jerryxiee/TPMS-SP370-SP40-FXTH87-Programer-Development-Kit/SP370/SP37Program错误异常处理.pdf

www.xiaojijiji.com | 小鸡叽叽科技

# SP37Program 错误异常处理

版本号 | 文件创建日期 | 最后修改日期 | 作者 | 签核
V2.0 | 2016-03-22 | 2016-07-06 | Deathgod
V2.1 | - | 2016-09-02 | Deathgod
http://www.xiaojijiji.com/小鸡叽叽科技

感谢您支持小鸡叽叽科技，请保护作者的劳动成果，未经允许不得将资料、代码传送他人或者网络

## 1.SP37Program 打开异常

SP37Program 需要 Microsoft .NET Framework 运行环境。(本人使用的是 4.5 版本) 如果软件无法打开，或出现其他异常。请先下载安装 Microsoft .NET Framework 最低版本 4.0 (WIN XP 用户选择 4.0)

下载地址:
推荐百度自行搜索下载(4.5 版本，大小 66M 左右)

(以下为微软官网，在线安装，可能会耗费较长的时间)
https://www.microsoft.com/zh-cn/download/confirmation.aspx?id=30653

## 2.串口驱动安装(以 win7 系统为例子) CH340G 串口驱动

1. 插入烧录开发板(不带屏幕的板子)
2. 进入电脑“设备管理器”，查看串口驱动是否成功安装
3. 若出现右图所示，请先安装串口驱动“CH340G 串口驱动” windows 可能会自动安装，如果没有自动安装，请手动安装 文件位于” CH340G 串口驱动 WINXP WIN7 WIN10 共用”
4. 安装完成后重新拔插设备

## 3.手动安装 CH340G 串口驱动

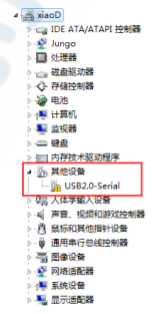
[picture p58: figure]

串口驱动未安装

STEP1

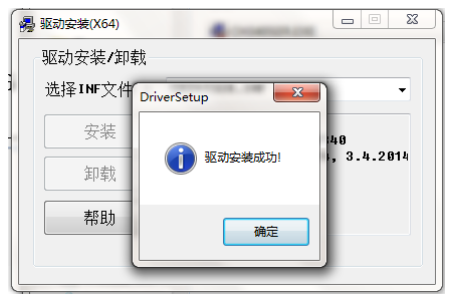
[picture p59: figure]
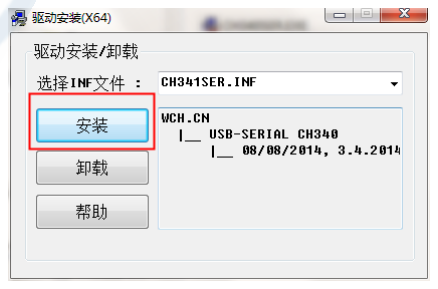
[picture p60: figure]

STEP2 | 成功安装

## 4.CH340G 驱动安装成功 “设备管理器可查看到 COM”

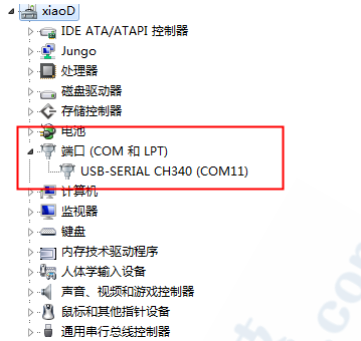
[picture p61: figure]

通过“设备管理器”也可以看到串口安装成功
这里串口号 COM11
