jerryxiee/TPMS-SP370-SP40-FXTH87-Programer-Development-Kit/SP400/Hardware/SP40 Module/bom.xlsx

Designator | LibRef | Footprint | Comment | Quantity
B1 | 纽扣电池 | CR1632 | 纽扣电池 | 1
C1, C2 | CAP | 0603_C | 8.2pF | 2
C3 | CAP | 0603_C | 68pF | 1
C4, C5 | CAP | 0603_C | 16pF | 2
C6 | CAP | 0603_C | 100nF | 1
C7 | CAP | 0603_C | 700nF | 1
C8 | CAP | 0603_C | 10nF | 1
C9 | CAP | 0603_C | 30pF | 1
C10 | CAP | 0603_C | 218pF | 1
L1 | Inductor | 0603_L | 56nH | 1
L2 | Inductor | 0603_L | 100nH | 1
L3 | Inductor | 0603_L | 15nH | 1
L4 | 低频电感 | EPCOS_7.2mH | 7.1mH | 1
P1 | Header 4 | HDR_2.0_4 | Header 4 | 1
P2 | Header 2 | HDR_2.0_2 | Header 2 | 1
Q1 | XTAL | XTAL_3225 | 26M | 1
R1 | RES | 0603_R | 41KOhm | 1
U1 | SP40 | SP40 | SP40 | 1
