jerryxiee/TPMS-SP370-SP40-FXTH87-Programer-Development-Kit/SP400/Hardware/SP40/SP40 Kit V2.0.pdf

# 螺丝孔

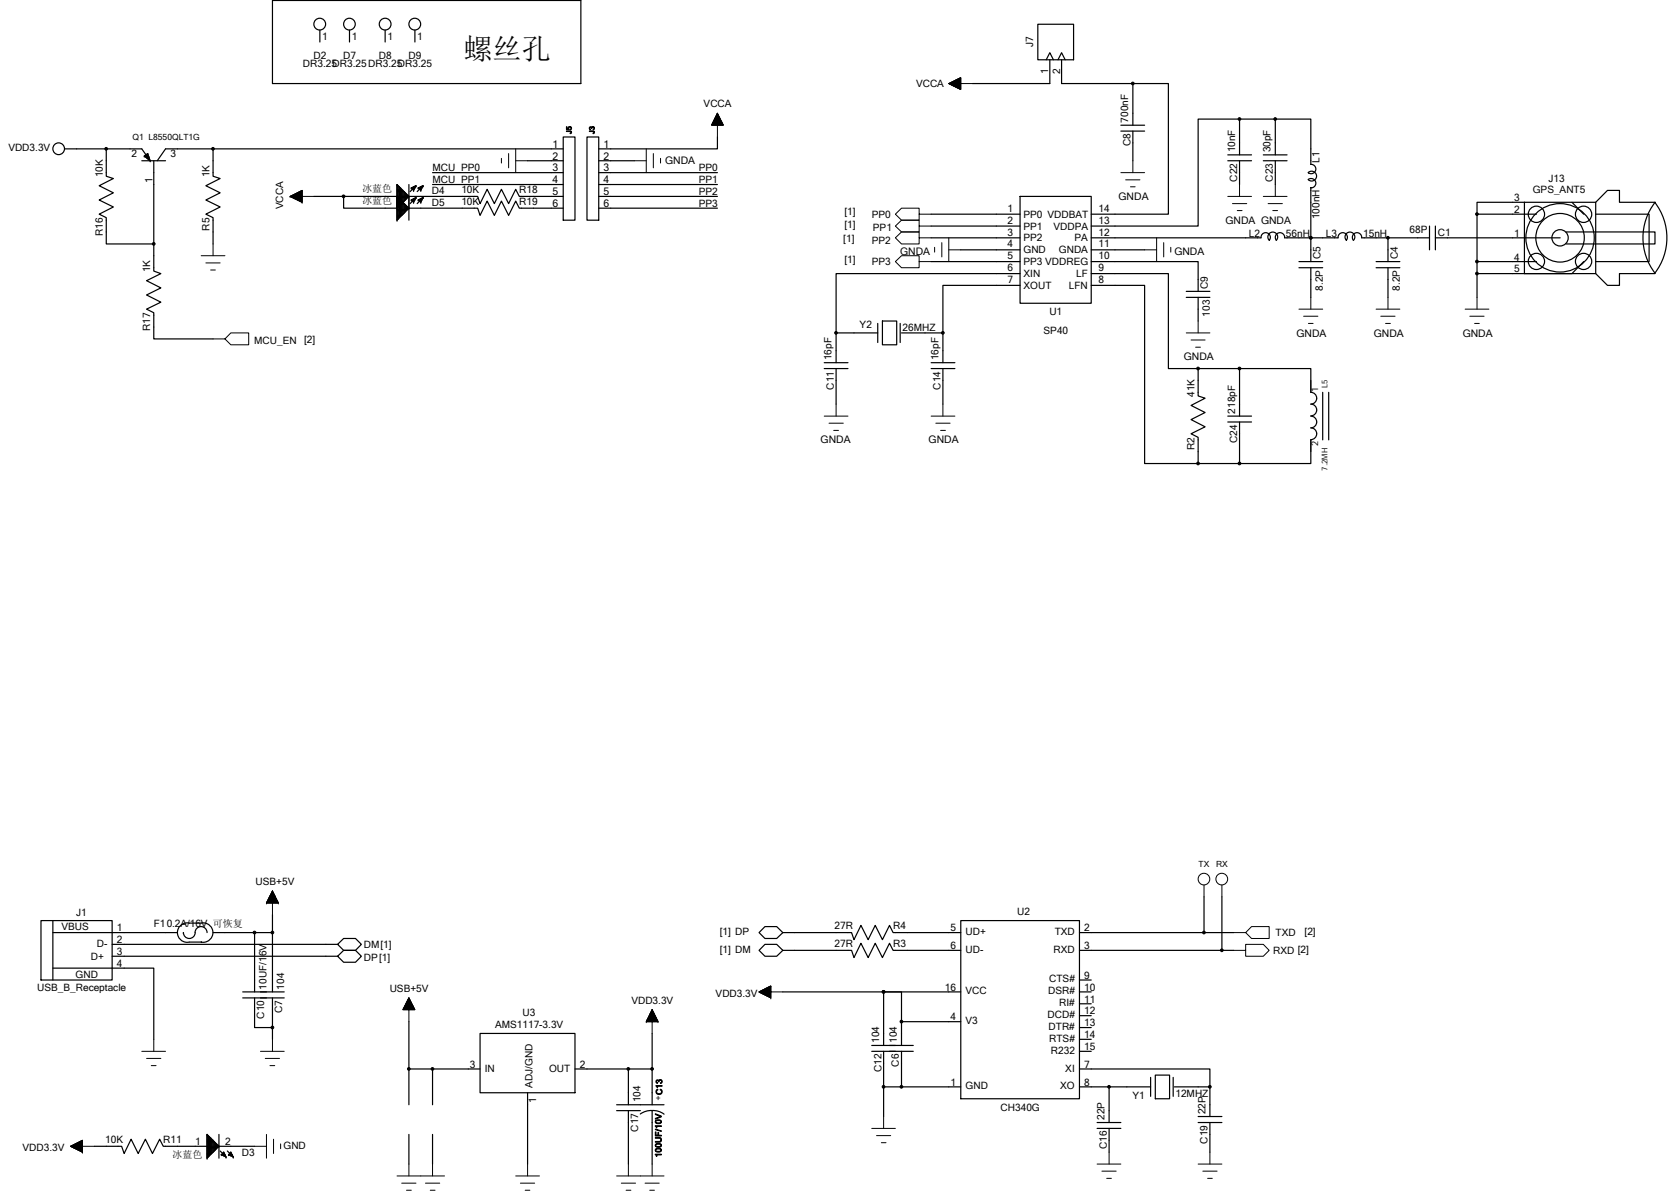
[picture p64: page 1]

1 ADJ/GND 3 OUT 2 IN

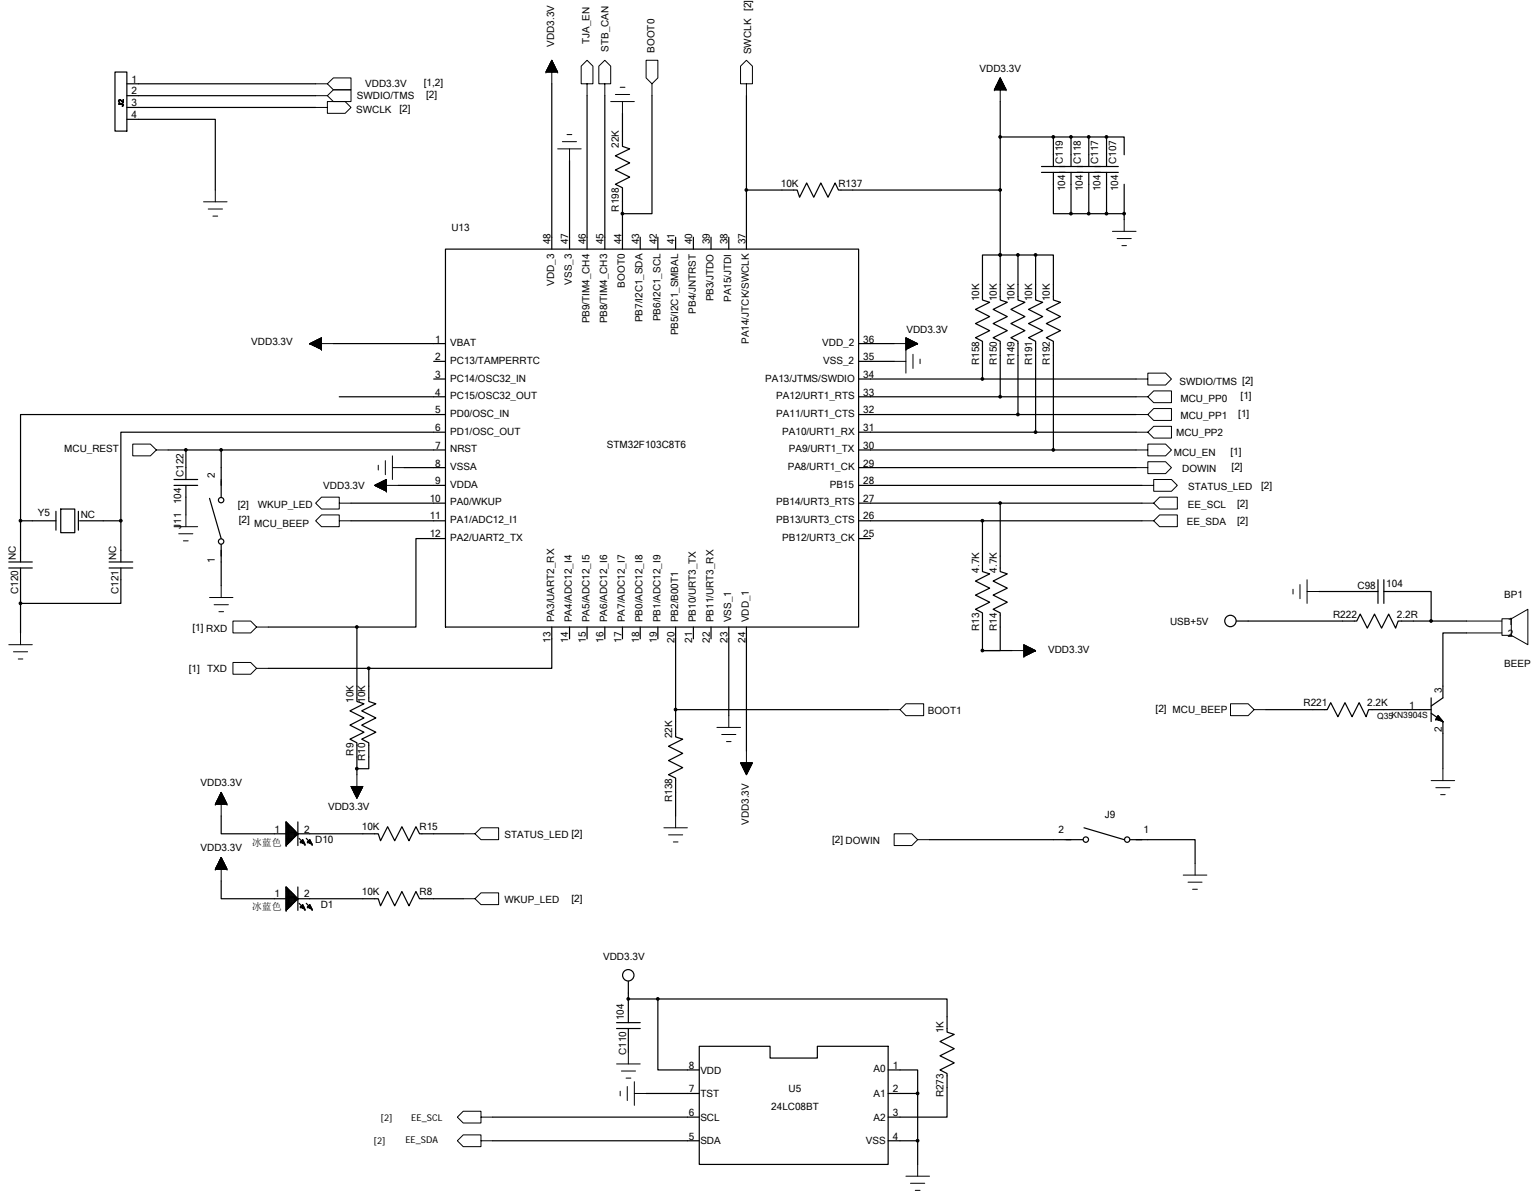
[picture p65: page 2]
