jerryxiee/TPMS-SP370-SP40-FXTH87-Programer-Development-Kit/SP370/Hardware/SP370 Kit E2.5.pdf

# 螺丝孔

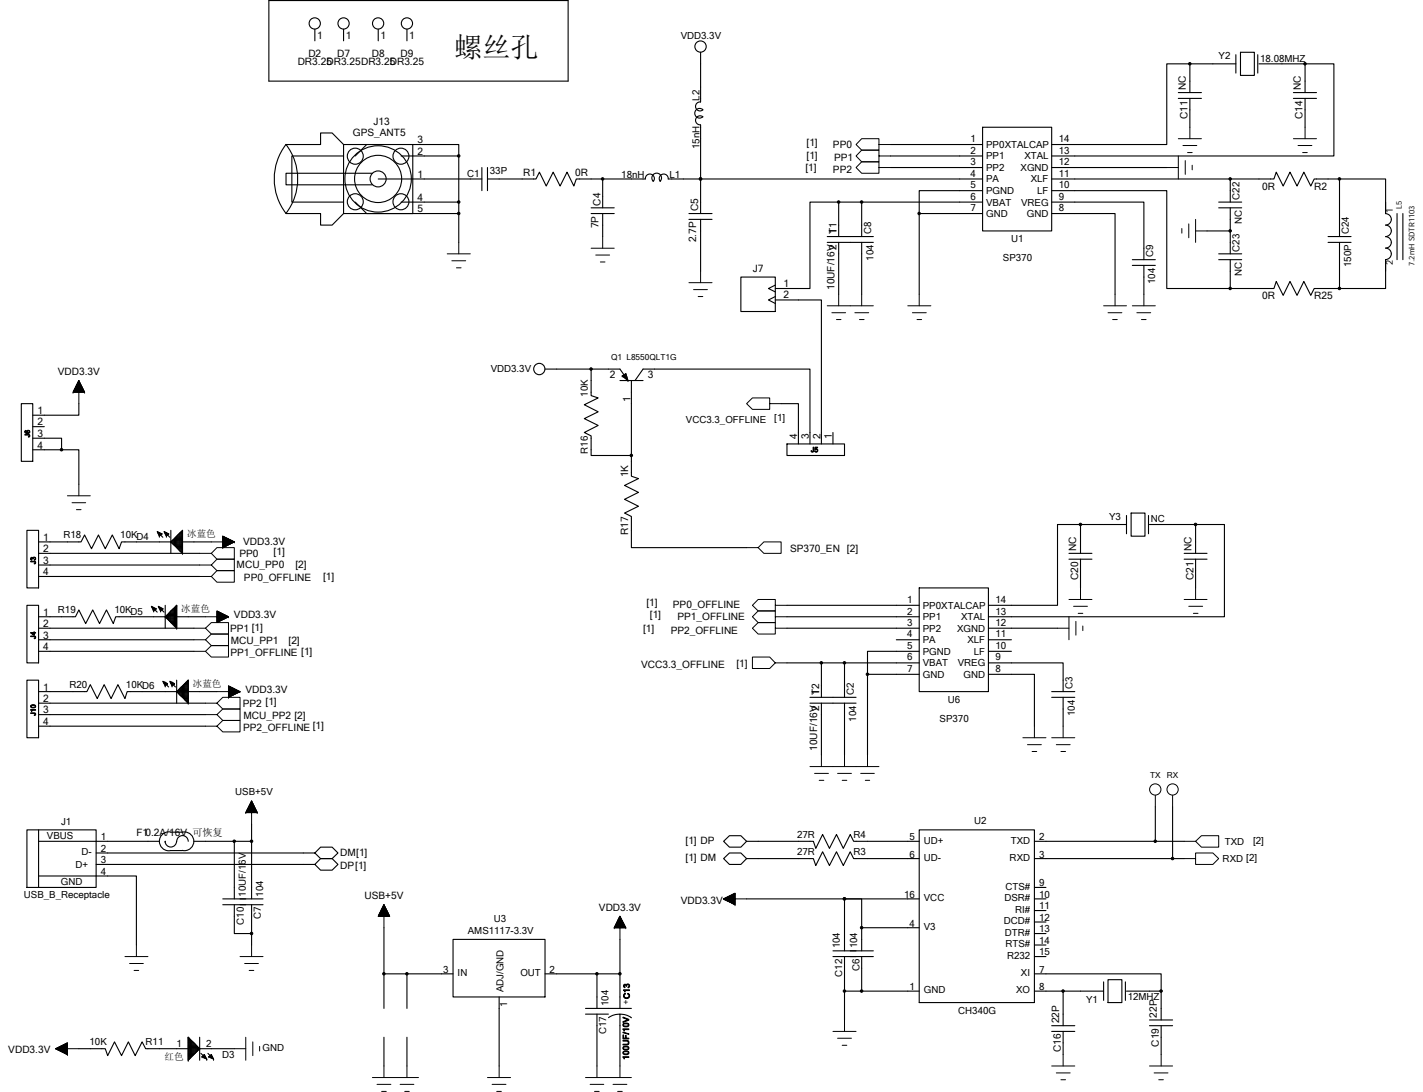
[picture p66: page 1]

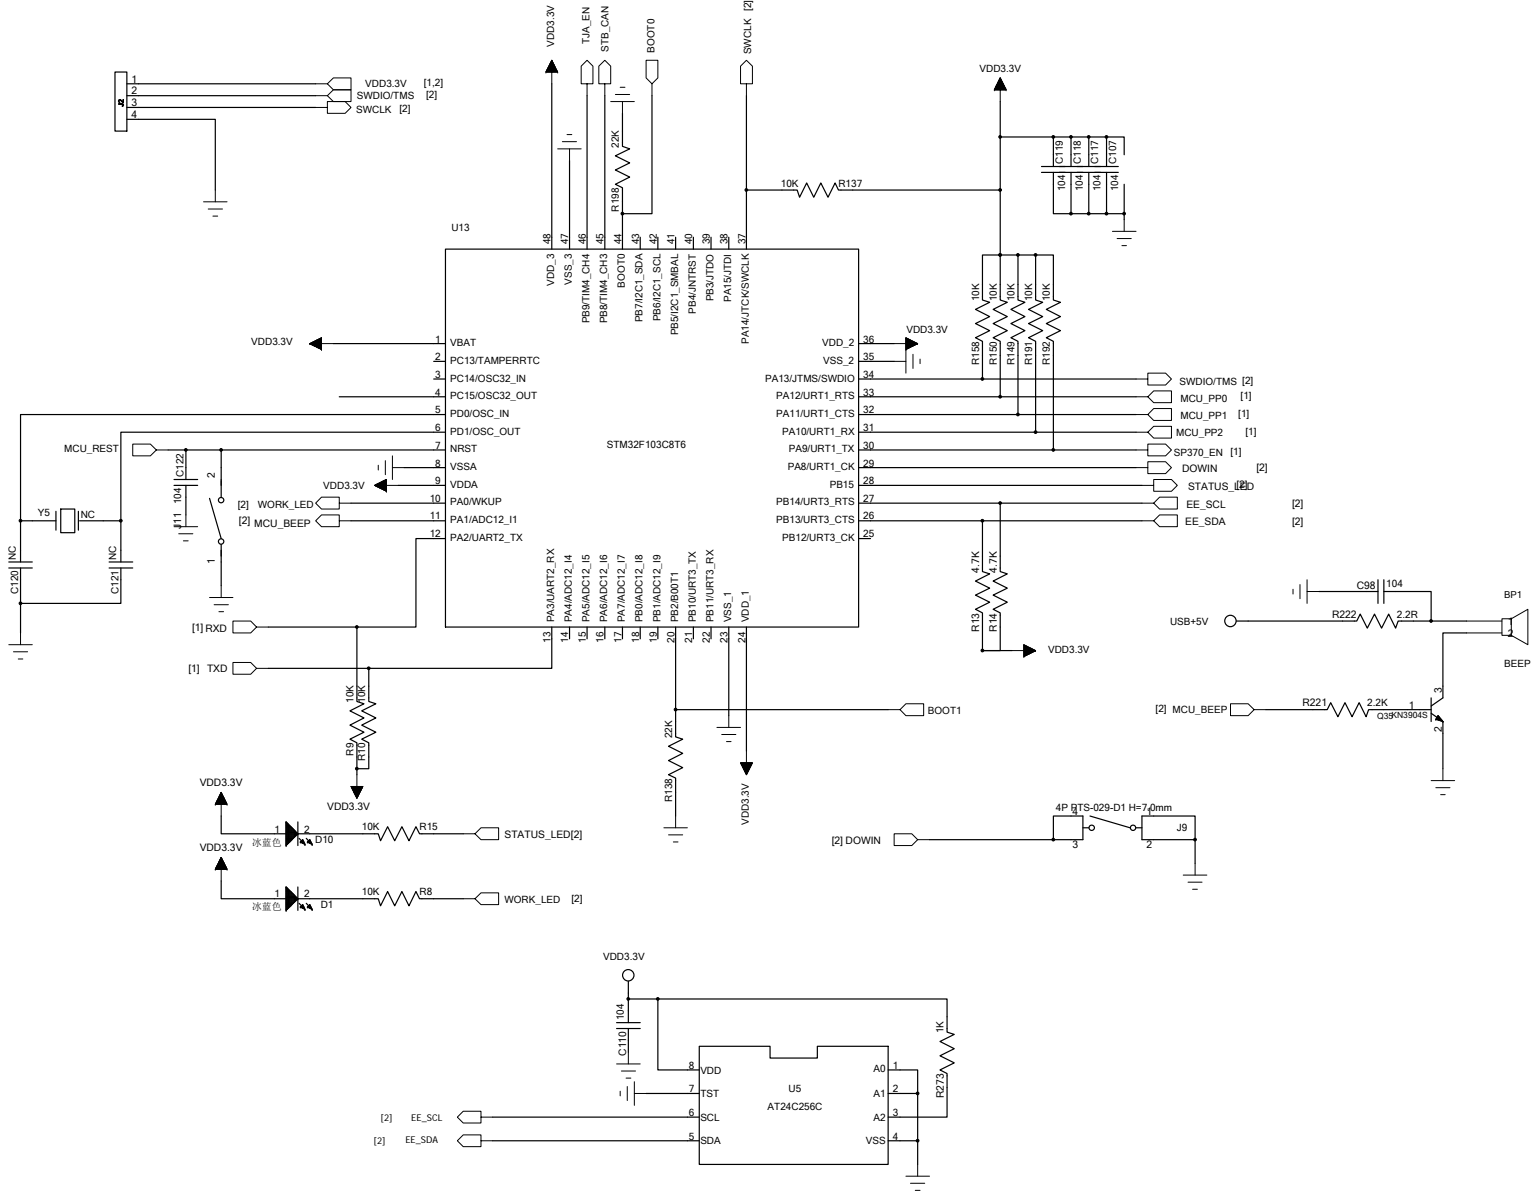
[picture p67: page 2]
