jerryxiee/TPMS-SP370-SP40-FXTH87-Programer-Development-Kit/SP370/Hardware/TDA5235 Kit V2.6.pdf

# 螺丝孔

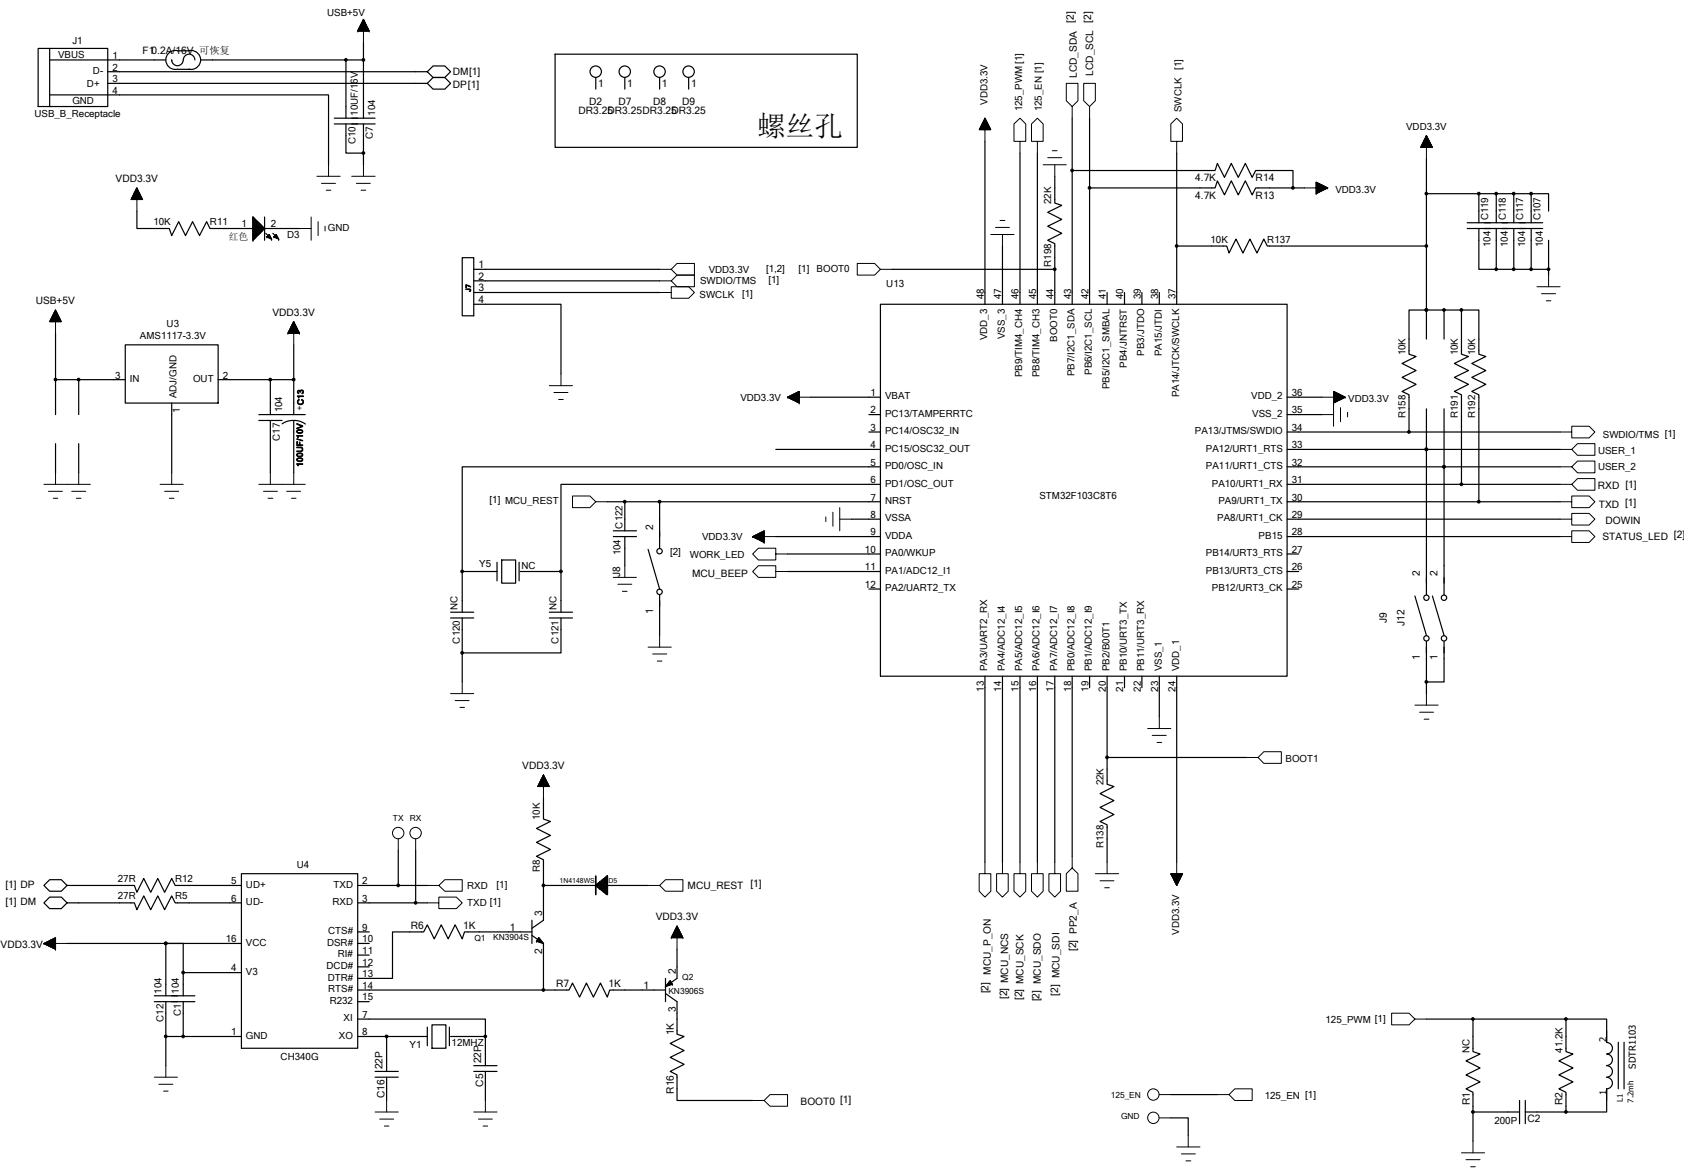
[picture p68: page 1]

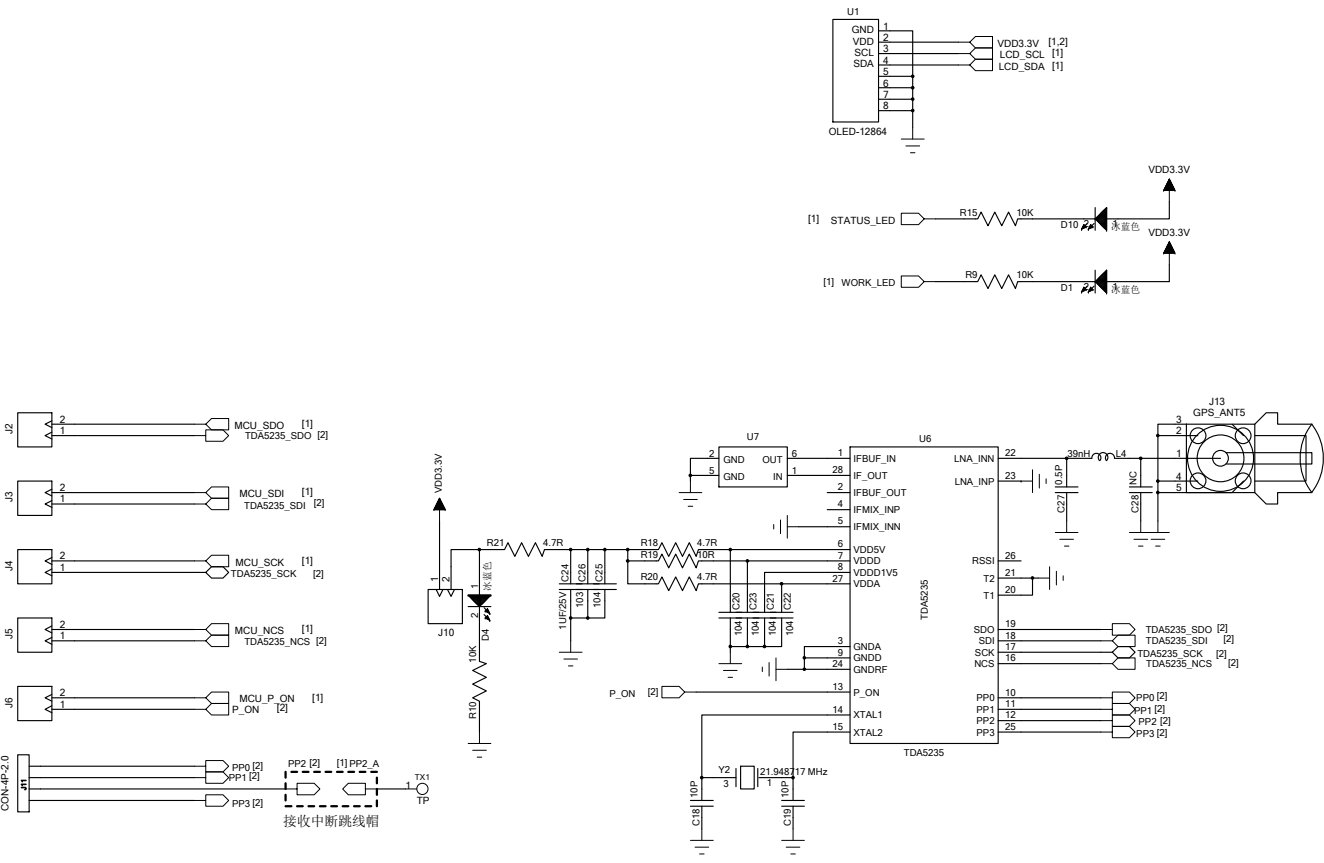
[picture p69: page 2]
