jerryxiee/TPMS-SP370-SP40-FXTH87-Programer-Development-Kit/FXTH87/Hardware/FXTH87 Kit/FXTH87 Kit V1.00.pdf

# ÂÝË¿¿×

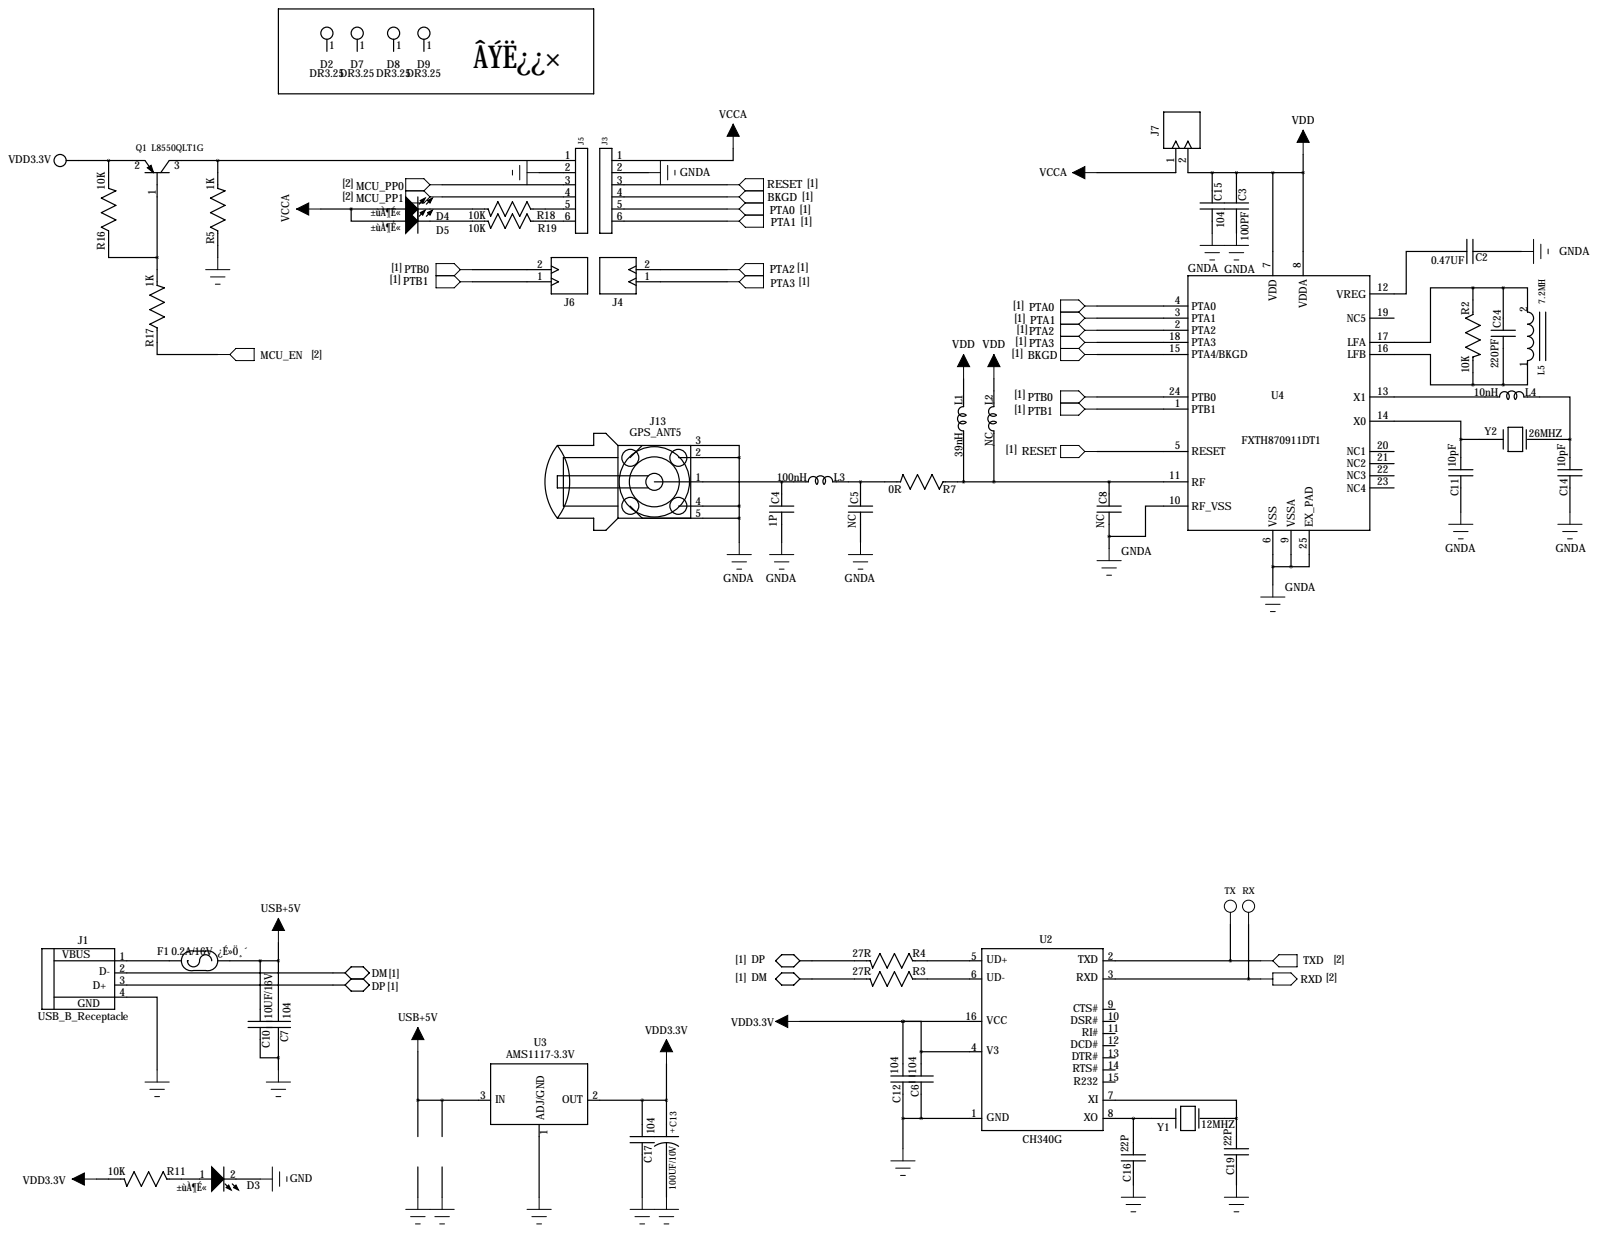
[picture p70: page 1]

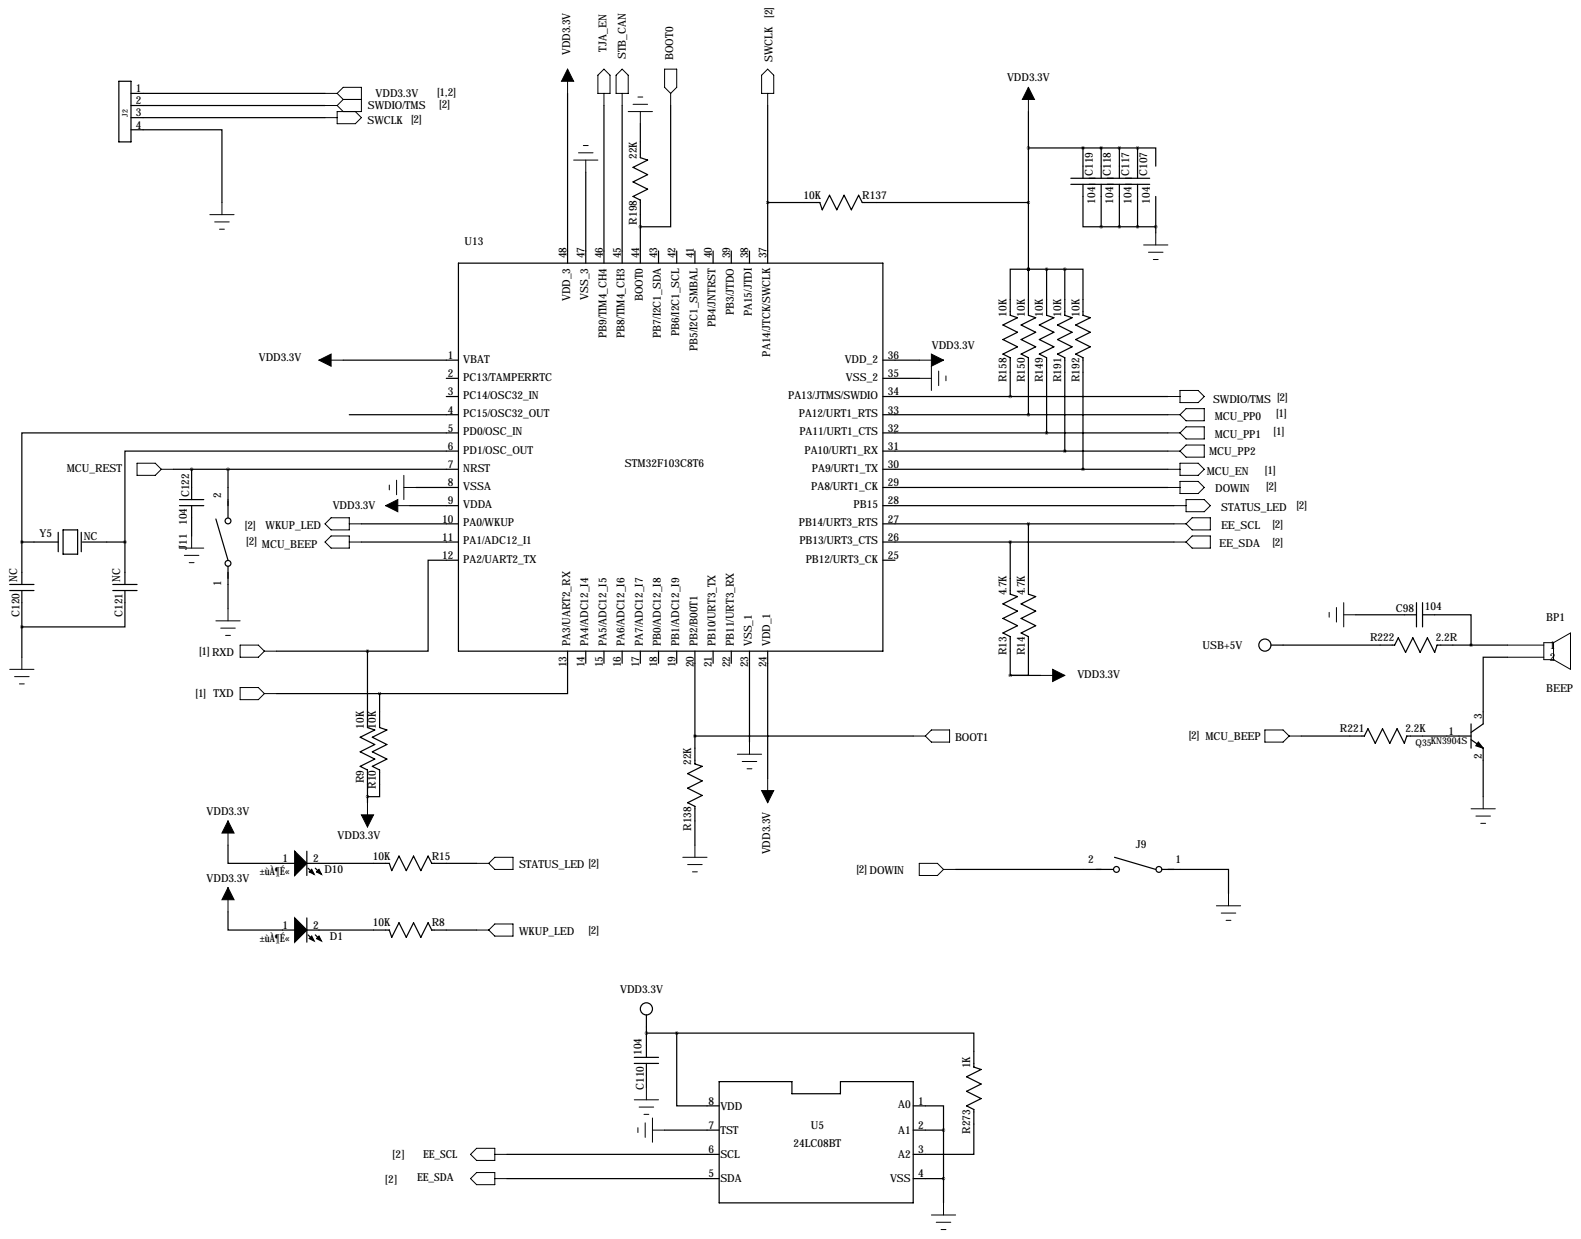
[picture p71: page 2]
