jerryxiee/TPMS-SP370-SP40-FXTH87-Programer-Development-Kit/SP400/Hardware/SP40 Module/V2.pdf

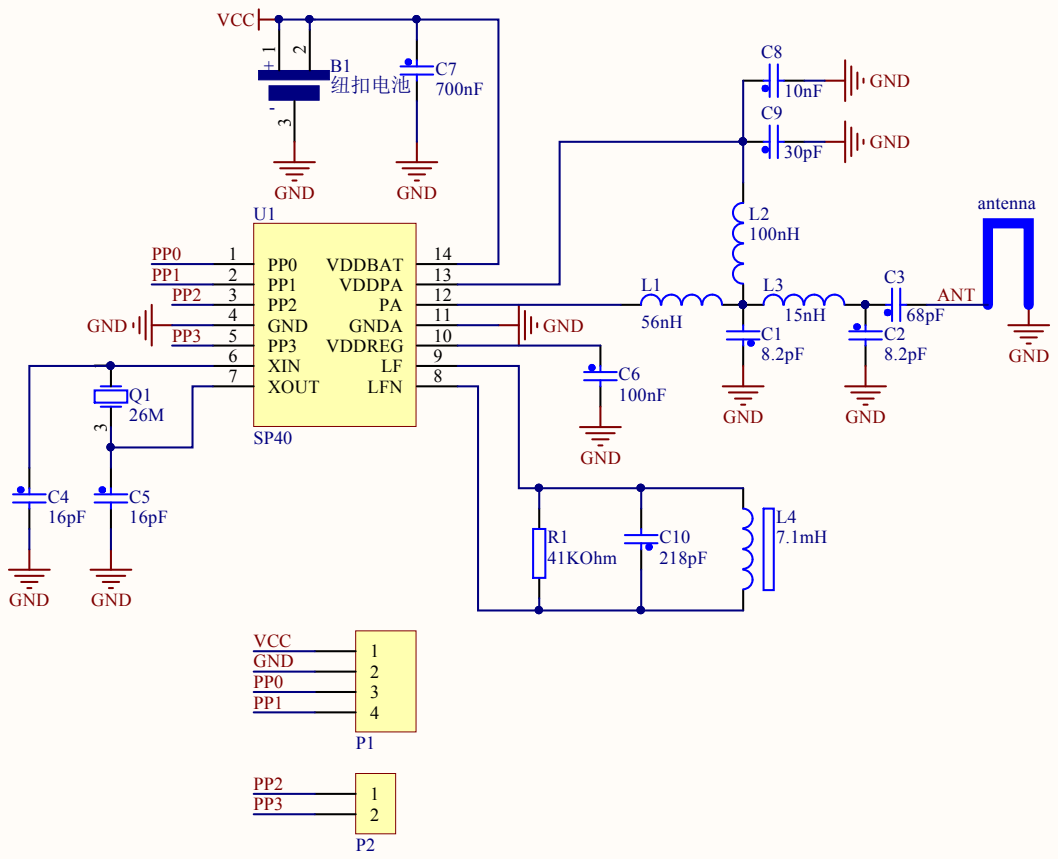
[picture p72: page 1]
