jerryxiee/TPMS-SP370-SP40-FXTH87-Programer-Development-Kit/SP370/TDA5235 Code/09.SP37_RFData_To_OLED_WithCRC/User/main.c

#include "sys.h"
#include "clock.h"
#include "delay.h"
#include "usart.h"
#include "led.h"
#include "tim.h"

#include "oled.h"
#include "display.h"

#include "TDA5235.h"
#include "TDA5235_SFR.h"

#include "SP37Data.h"


/* ************************************************************************************************** */
/* ************************************************************************************************** */
/* ************************************************************************************************** */
/* ************************************************************************************************** */
/*   ----------------------------------------------------------------------------------------------   */
/*                                          小鸡叽叽科技出品                                          */
/*                                         www.xiaojijiji.com                                         */
/*   ----------------------------------------------------------------------------------------------   */
/* ************************************************************************************************** */
/* ************************************************************************************************** */
/* ************************************************************************************************** */
/* ************************************************************************************************** */
/*   -----------------------------------------------------------------------------------------------  */
/*	                     感谢您支持小鸡叽叽科技，请遵守保密协议，保护作者的劳动成果，                 */
/*                                  未经允许请不要将资料、代码传送他人或者网络	                      */
/*                                             仅供内部使用                                           */
/* ************************************************************************************************** */


int main(void)
{

	Clock_Init();
	NVIC_Configuration();		//中断配置
	delay_init();
	LED_Init();
	USART1_Init(115200);		//USART1初始化,波特率115200	

	Tim3_Init(1000,64); 		//1ms的溢出中断 //系统灯闪烁
	TIM3_Cmd(ENABLE);


	OLED_Init(); 
 
	Display_Logo();  
	Display_Http();
	Display_Version();  

	Display_User_ID_NULL();
	Display_RF_Receive_Mark();

	Display_Pressure(0); 
	Display_Temperature(0);
	Display_Acceleration(0);
	Display_Voltage(0);

	TDA5235_Init();
	TDA5235_SFR_Init();
	
	while(1)
	{
		if(TDA5235_FIFO_NUM){
			PT_SP37_RF_DATA pt_SP37Data = (PT_SP37_RF_DATA)TDA5235_FIFO;

			LED_ReceiveReverse();		//STATUS灯闪烁
			Display_RF_Receive_Count_Plus();
			Display_Logo_Move();

			Display_User_ID(pt_SP37Data->IDH,pt_SP37Data->IDL);
			Display_Pressure(SP37_Cal_Pressure(pt_SP37Data->Pressure));
			Display_Temperature(SP37_Cal_Temperature(pt_SP37Data->Temperature));
			Display_Acceleration(SP37_Cal_Acceleration(pt_SP37Data->Acceleration));
			Display_Voltage(SP37_Cal_Voltage(pt_SP37Data->Voltage));

			TDA5235_FIFO_NUM = 0;	//清零

			printf("*****************************\r\n");
			printf("Get a message from SP370:\r\n");
			printf("Pressure:    %f\r\n",SP37_Cal_Pressure(pt_SP37Data->Pressure));
			printf("Temperature: %f\r\n",SP37_Cal_Temperature(pt_SP37Data->Temperature));
			printf("Acceleration:%f\r\n",SP37_Cal_Acceleration(pt_SP37Data->Acceleration));
			printf("Voltage:     %f\r\n",SP37_Cal_Voltage(pt_SP37Data->Voltage));
			printf("*****************************\r\n");
		}
	}


}


/*	头文件路径
.\CORE;..\FWLib\inc;.\INCLUDE
*/
