jerryxiee/TPMS-SP370-SP40-FXTH87-Programer-Development-Kit/SP370/SP370 Code/03.UART/user/main.c

/* ************************************************************************************************** */
/* ************************************************************************************************** */
/* ************************************************************************************************** */
/* ************************************************************************************************** */
/*   ----------------------------------------------------------------------------------------------   */
/*                                          小鸡叽叽科技出品		                                  		*/
/*                                         www.xiaojijiji.com		                                  		*/
/*   ----------------------------------------------------------------------------------------------   */
/* ************************************************************************************************** */
/* ************************************************************************************************** */
/* ************************************************************************************************** */
/* ************************************************************************************************** */
/*   -----------------------------------------------------------------------------------------------  */
/*	                     感谢您支持小鸡叽叽科技，请遵守保密协议，保护作者的劳动成果，                 */
/*                                  未经允许请不要将资料、代码传送他人或者网络	                      */
/*																		         仅供内部使用                                           */
/* ************************************************************************************************** */



#include "Reg_SP37.h"
#include "SP37_ROMLibrary.h"
#include <uart.h>
#include <stdio.h>
#include <ctype.h>

void MAIN(void)
{
	Uart_Init();
	
	while(1){

		WDRES = 1;		//喂看门狗
		printf("%s\r\n","SP370 Printf Test...");
		printf("十进制:%d\r\n",10000);
		printf("字符:%c\r\n",'A');
		//打印16进制需要将数据强制为int
		printf("十六进制:0x%X\r\n",(int)0xAA);

		//延时1S
		Wait100usMultiples(10000);
	}
}
