jerryxiee/TPMS-SP370-SP40-FXTH87-Programer-Development-Kit/SP370/SP370 Code/04.Temperature/user/main.c

/* ************************************************************************************************** */
/* ************************************************************************************************** */
/* ************************************************************************************************** */
/* ************************************************************************************************** */
/*   ----------------------------------------------------------------------------------------------   */
/*                                          小鸡叽叽科技出品		                                  		*/
/*                                         www.xiaojijiji.com		                                  		*/
/*   ----------------------------------------------------------------------------------------------   */
/* ************************************************************************************************** */
/* ************************************************************************************************** */
/* ************************************************************************************************** */
/* ************************************************************************************************** */
/*   -----------------------------------------------------------------------------------------------  */
/*	                     感谢您支持小鸡叽叽科技，请遵守保密协议，保护作者的劳动成果，                 */
/*                                  未经允许请不要将资料、代码传送他人或者网络	                      */
/*																		         仅供内部使用                                           */
/* ************************************************************************************************** */


#include "Reg_SP37.h"
#include "SP37_ROMLibrary.h"
#include <uart.h>
#include <stdio.h>
#include <ctype.h>


void MAIN(void)
{
	unsigned char StatusByte;
	struct{
		signed int Compensated_Temperature;
		signed int Raw_Temperature;
	}idata Temp_Result;

	//串口初始化
	Uart_Init();

	while(1)
	{
		WDRES = 1;
		StatusByte = Meas_Temperature(&Temp_Result.Compensated_Temperature);
		if(!StatusByte)
		{
			printf("The Temperature is %f\r\n",(double)Temp_Result.Compensated_Temperature/128);
		}
		else
		{
			printf("The Temperature Measure Error\r\n");
		}
		Wait100usMultiples(1000);
	}

}
