jerryxiee/TPMS-SP370-SP40-FXTH87-Programer-Development-Kit/SP370/TDA5235 Code/03.USART/User/main.c

#include "sys.h"
#include "clock.h"
#include "delay.h"
#include "usart.h"

#include "led.h"


/* ************************************************************************************************** */
/* ************************************************************************************************** */
/* ************************************************************************************************** */
/* ************************************************************************************************** */
/*   ----------------------------------------------------------------------------------------------   */
/*                                          小鸡叽叽科技出品                                          */
/*                                         www.xiaojijiji.com                                         */
/*   ----------------------------------------------------------------------------------------------   */
/* ************************************************************************************************** */
/* ************************************************************************************************** */
/* ************************************************************************************************** */
/* ************************************************************************************************** */
/*   -----------------------------------------------------------------------------------------------  */
/*	                     感谢您支持小鸡叽叽科技，请遵守保密协议，保护作者的劳动成果，                 */
/*                                  未经允许请不要将资料、代码传送他人或者网络	                      */
/*                                             仅供内部使用                                           */
/* ************************************************************************************************** */


int main(void)
{

	Clock_Init();
	NVIC_Configuration();		//中断配置
	delay_init();
	USART1_Init(115200);		//USART1初始化,波特率115200

	LED_Init();

	while(1)
	{
		printf("-------------------------------\r\n");
		printf("%s\r\n","STM32 Printf Test...");
		printf("十进制:%d\r\n",10000);
		printf("字符型:%c\r\n",'A');
		printf("十六进制:0x%02X\r\n",0xAA);
		printf("浮点数:%f\r\n",1.2345678);
		printf("www.xiaojijiji.com\r\n");
		printf("Designed By Deathgod\r\n");
		printf("-------------------------------\r\n");
		delay_ms(500);

	}

}


/*	头文件路径
.\CORE;..\FWLib\inc;.\INCLUDE
*/
