jerryxiee/TPMS-SP370-SP40-FXTH87-Programer-Development-Kit/SP370/TDA5235 Code/04.GET_TDA5235_ID/User/main.c

#include "sys.h"
#include "clock.h"
#include "delay.h"
#include "usart.h"

#include "led.h"

#include "TDA5235.h"
#include "TDA5235_SFR.h"

/* ************************************************************************************************** */
/* ************************************************************************************************** */
/* ************************************************************************************************** */
/* ************************************************************************************************** */
/*   ----------------------------------------------------------------------------------------------   */
/*                                          小鸡叽叽科技出品                                          */
/*                                         www.xiaojijiji.com                                         */
/*   ----------------------------------------------------------------------------------------------   */
/* ************************************************************************************************** */
/* ************************************************************************************************** */
/* ************************************************************************************************** */
/* ************************************************************************************************** */
/*   -----------------------------------------------------------------------------------------------  */
/*	                     感谢您支持小鸡叽叽科技，请遵守保密协议，保护作者的劳动成果，                 */
/*                                  未经允许请不要将资料、代码传送他人或者网络	                      */
/*                                             仅供内部使用                                           */
/* ************************************************************************************************** */


int main(void)
{

	Clock_Init();
	NVIC_Configuration();		//中断配置
	delay_init();
	USART1_Init(115200);		//USART1初始化,波特率115200

	LED_Init();

	TDA5235_Init();
	
	while(1)
	{
		u8 i;
		u8 ID[4] = {0};

		for(i=0;i<4;i++){
			ID[i] = TDA5235_Read_Register(SFR_SN0 + i);
		}

		printf("TDA5235 ID: ");
		for(i=0;i<4;i++){
			printf("%02X,",ID[i]);
		}
		printf("\r\n");
		
		delay_ms(500);		
	}


}


/*	头文件路径
.\CORE;..\FWLib\inc;.\INCLUDE
*/
