jerryxiee/TPMS-SP370-SP40-FXTH87-Programer-Development-Kit/SP370/TDA5235 Code/11.Send_125Khz_LF_Telegram/User/display.c

#include "sys.h"
#include "oled.h"
#include "display.h"

#include "mysprintf.h"

#include <math.h>

#include "sp37data.h"

//默认显示在第一行,与第二行的第一个像素点
void Display_Logo(void)
{
	OLED_ShowBMP(LOGO_START_X,LOGO_START_PAGE,0);
	//OLED_ShowBMP(LOGO_MOVE_X_MIN,LOGO_MOVE_PAGE,1);
}

void Display_Http(void)
{
	OLED_ShowStr(HTTP_START_X,HTTP_START_PAGE,"www.xiaojijiji.com");
}

void Display_Version(void)
{
	//OLED_ShowStr(VERSION_START_X,VERSION_START_PAGE,"SP37 Receiver V2.5");
	OLED_ShowStr(VERSION_START_X,VERSION_START_PAGE," .Send 125Khz LF. ");
}


#define LOGO_MOVE_TO_RIGHT	0
#define LOGO_MOVE_TO_LEFT	1	

void Display_Logo_Move(void)
{
	static u8 pos = 0;
	static u8 dir = LOGO_MOVE_TO_RIGHT;

	OLED_CleanBMP(pos,LOGO_MOVE_PAGE);

	if(dir==LOGO_MOVE_TO_RIGHT){		//向右移动
		pos ++;
		if(pos >= LOGO_MOVE_X_MAX){
			dir = LOGO_MOVE_TO_LEFT;
		}
		OLED_ShowBMP(pos,LOGO_MOVE_PAGE,1);
	}else{								//向左移动
		pos --;
		if(pos <= LOGO_MOVE_X_MIN){
			dir = LOGO_MOVE_TO_RIGHT;
		}
		OLED_ShowBMP(pos,LOGO_MOVE_PAGE,0);
	}
	
	

}

//默认16个数据
//没有更新的地方为0
void Display_Data(u8 *data)
{
	u8 i;

	char strArr[32]={0};
	char *str = strArr;

	//第一行数据	
	*str = 'D';	str++;
	*str = '0';	str++;
	*str = ':';	str++;

	for(i=0;i<8;i++){
		str += MySprintf_x(str,data[i]);
	}

	OLED_ShowStr(DATA_START_X,DATA_START_PAGE1,strArr);

	//第二行数据
	str = strArr;
	*str = 'D';	str++;
	*str = '1';	str++;
	*str = ':';	str++;

	for(i=8;i<16;i++){
		str += MySprintf_x(str,data[i]);
	}

	OLED_ShowStr(DATA_START_X,DATA_START_PAGE2,strArr);	
	
}

//显示" Re: "  这个三个字符串
void Display_RF_Receive_Mark(void)
{
	char strArr[32]={0};
	char *str = strArr;

	*str = 'R';	str++;
	*str = 'e';	str++;
	*str = ':';	str++;

	MySprintf_ud(str,0,4);
	OLED_ShowStr(RF_RECEIVE_MARK_START_X,RF_RECEIVE_MARK_PAGE,strArr);	
}


void Display_RF_Receive_Count_Plus(void)
{
	char strArr[32]={0};
	char *str = strArr;

	static u16 Count = 0;

	Count ++;
	if(Count > 9999){
		Count = 0;
	}
	
	MySprintf_ud(str,Count,4);
	OLED_ShowStr(RF_RECEIVE_COUNT_START_X,RF_RECEIVE_COUNT_PAGE,strArr);
}

//在没有收到ID之前，显示XXXX
void Display_User_ID_NULL(void)
{
	char strArr[32]={0};
	char *str = strArr;

	*str = 'I';	str++;
	*str = 'D';	str++;
	*str = ':';	str++;
	
	*str = 'X';	str++;
	*str = 'X';	str++;
	*str = 'X';	str++;
	*str = 'X';	str++;

	OLED_ShowStr(USER_ID_START_X,USER_ID_START_PAGE,strArr);

}

void Display_User_ID(u8 IDH,u8 IDL)
{
	char strArr[32]={0};
	char *str = strArr;

	static u8 lastIDH = 0xFF;
	static u8 lastIDL = 0xFF;

	if(lastIDH==IDH && lastIDL==IDL){
		return;
	}else{
		lastIDH = IDH;
		lastIDL = IDL;
	}

	*str = 'I';	str++;
	*str = 'D';	str++;
	*str = ':';	str++;
	
	str += MySprintf_x(str,IDH);
	str += MySprintf_x(str,IDL);

	OLED_ShowStr(USER_ID_START_X,USER_ID_START_PAGE,strArr);
}



//在没有收到ID之前，显示XXXXXXXX
void Display_Unique_ID_NULL(void)
{
	char strArr[32]={0};
	char *str = strArr;

	*str = 'I';	str++;
	*str = 'D';	str++;
	*str = ':';	str++;
	
	*str = 'X';	str++;
	*str = 'X';	str++;
	*str = 'X';	str++;
	*str = 'X';	str++;
	*str = 'X';	str++;
	*str = 'X';	str++;
	*str = 'X';	str++;
	*str = 'X';	str++;

	OLED_ShowStr(UNIQUE_ID_START_X,UNIQUE_ID_START_PAGE,strArr);

}

void Display_Unique_ID(u8 *UniqueID)
{
	char strArr[32]={0};
	char *str = strArr;

	static u8 lastUniqueID[4] = {0xFF,0XFF,0xFF,0xFF};

	if(	lastUniqueID[0]==UniqueID[0] && 
		lastUniqueID[1]==UniqueID[1] &&
		lastUniqueID[2]==UniqueID[2] && 
		lastUniqueID[3]==UniqueID[3]){
		return;
	}else{
		lastUniqueID[0]=UniqueID[0];
		lastUniqueID[1]=UniqueID[1];
		lastUniqueID[2]=UniqueID[2];
		lastUniqueID[3]=UniqueID[3];
	}

	*str = 'I';	str++;
	*str = 'D';	str++;
	*str = ':';	str++;
	
	str += MySprintf_x(str,UniqueID[0]);
	str += MySprintf_x(str,UniqueID[1]);
	str += MySprintf_x(str,UniqueID[2]);
	str += MySprintf_x(str,UniqueID[3]);

	OLED_ShowStr(UNIQUE_ID_START_X,UNIQUE_ID_START_PAGE,strArr);
}


void Display_Tyre_Position(u8 tyrePosition)
{
	char strArr[32]={0};
	char *str = strArr;

	u8 lastTyrePosition = Unknown;

	if(lastTyrePosition==tyrePosition){
		return;
	}else{
		lastTyrePosition = tyrePosition;
	}

	switch(tyrePosition){
	case LF:
		*str = 'L';	str++;
		*str = 'F';	str++;
		break;
	case RF:
		*str = 'R'; str++;
		*str = 'F'; str++;
		break;
	case LB:
		*str = 'L'; str++;
		*str = 'B'; str++;
		break;
	case RB:
		*str = 'R'; str++;
		*str = 'B'; str++;
		break;
	default:break;
	}


	OLED_ShowStr(TYRE_POSOTION_START_X,TYRE_POSOTION_START_PAGE,strArr);
}


void Display_Pressure(float pressure)
{
	char strArr[32]={0};
	char *str = strArr;

	static float lastVal = -1;
	if(fabs(lastVal - pressure) < 0.0001 ){
		return;
	}else{
		lastVal = pressure;
	} 

	*str = 'P';	str++;
	*str = ':';	str++;

	str += MySprintf_f(str,pressure,3,4);

	*str = ' ';	str++;
	
	*str = 'k';	str++;
	*str = 'P';	str++;
	*str = 'a';	str++;

	OLED_ShowStr(PRESSURE_START_X,PRESSURE_START_PAGE,strArr);
	
}


void Display_Temperature(float temperature)
{
	char strArr[32]={0};
	char *str = strArr;

	static float lastVal = -1;
	if(fabs(lastVal - temperature) < 0.0001 ){
		return;
	}else{
		lastVal = temperature;
	}

	*str = 'T';	str++;
	*str = ':';	str++;

	str += MySprintf_f(str,temperature,3,4);

	*str = ' ';	str++;
	
	*str = 95+32;	str++;		//特殊字符℃

	OLED_ShowStr(TEMPERATURE_START_X,TEMPERATURE_START_PAGE,strArr);
	
}


void Display_Acceleration(float acceleration)
{
	char strArr[32]={0};
	char *str = strArr;

	static float lastVal = -1;
	if(fabs(lastVal - acceleration) < 0.0001 ){
		return;
	}else{
		lastVal = acceleration;
	}

	*str = 'A';	str++;
	*str = ':';	str++;

	str += MySprintf_f(str,acceleration,3,4);

	*str = ' ';	str++;
	*str = 'g';	str++;
	

	OLED_ShowStr(ACCELERATION_START_X,ACCELERATION_START_PAGE,strArr);
	
}


void Display_Voltage(float voltage)
{
	char strArr[32]={0};
	char *str = strArr;

	static float lastVal = -1;
	if(fabs(lastVal - voltage) < 0.0001 ){
		return;
	}else{
		lastVal = voltage;
	}

	*str = 'V';	str++;
	*str = ':';	str++;

	str += MySprintf_f(str,voltage,3,4);

	*str = ' ';	str++;
	*str = 'v';	str++;
	

	OLED_ShowStr(VOLTAGE_START_X,VOLTAGE_START_PAGE,strArr);
	
}
