jerryxiee/TPMS-SP370-SP40-FXTH87-Programer-Development-Kit/SP370/SP370 Code/12.RF_ALL_V2/include/RF.h

#ifndef _RF_H
#define _RF_H

typedef struct SP37_DATA {
	ID_Struct ID_Result;	//���ڴ洢оƬΨһ���к�(UniqueId)
	unsigned char IDH;
	unsigned char IDL;
	E_Tyre_Position Tyre_Position;
	int Pressure;
	int Temperature;
	int Acceleration;
	int Voltage;
	unsigned char CRC;
}T_SP37_DATA;

char Send_RF(T_SP37_DATA idata t_sp37_data);

#endif
