jerryxiee/TPMS-SP370-SP40-FXTH87-Programer-Development-Kit/SP370/TDA5235 Code/08.TDA5235_RFData_OLED/INCLUDE/tim.h

#ifndef _TIM_H
#define _TIM_H

extern uint32_t time_1ms;

void Tim3_Init(u16 period_num,u16 prescaler_num);
void TIM3_Cmd(FunctionalState NewState);

void Tim4_Init(u16 period_num,u16 prescaler_num);

#endif
