jerryxiee/TPMS-SP370-SP40-FXTH87-Programer-Development-Kit/SP370/TDA5235 Code/08.TDA5235_RFData_OLED/User/tim.c

#include "sys.h"
#include "tim.h"

#include "led.h"

uint32_t time_1ms = 0;

/**************************************************/
//函数名字:void Tim3_Init(u16 period_num,u16 prescaler_num)
//输入参数:period_num:计数值
//		   prescaler_num:分频系数 >=1
//输出参数:
//描述:用于基本定时器，向上计数，产生溢出中断
/**************************************************/
void Tim3_Init(u16 period_num,u16 prescaler_num)
{
	TIM_TimeBaseInitTypeDef TIM_TimeBaseInitStruct;
	NVIC_InitTypeDef NVIC_InitStruct;

	RCC_APB1PeriphClockCmd(RCC_APB1Periph_TIM3,ENABLE);

	TIM_TimeBaseInitStruct.TIM_ClockDivision = TIM_CKD_DIV1;
	TIM_TimeBaseInitStruct.TIM_CounterMode = TIM_CounterMode_Up;
	TIM_TimeBaseInitStruct.TIM_Period = period_num;
	TIM_TimeBaseInitStruct.TIM_Prescaler = prescaler_num - 1;	
	TIM_TimeBaseInit(TIM3,&TIM_TimeBaseInitStruct);

	NVIC_InitStruct.NVIC_IRQChannel = TIM3_IRQn;
	NVIC_InitStruct.NVIC_IRQChannelCmd = ENABLE;
	NVIC_InitStruct.NVIC_IRQChannelPreemptionPriority = 14;
	NVIC_InitStruct.NVIC_IRQChannelSubPriority = 0;

	NVIC_Init(&NVIC_InitStruct);

	TIM_ClearFlag(TIM3,TIM_FLAG_Update);
	TIM_ITConfig(TIM3,TIM_IT_Update,ENABLE);

}


void TIM3_Cmd(FunctionalState NewState)
{
	TIM_Cmd(TIM3,NewState);
}

/**************************************************/
//描述:用于接收MPU6050的数据(1ms中断一次)
//     产生时间基准 tim_1ms ++ 
//     
/**************************************************/
void TIM3_IRQHandler(void)
{	
	if(TIM_GetITStatus(TIM3,TIM_IT_Update) != RESET)
	{
		TIM_ClearITPendingBit(TIM3,TIM_IT_Update);
		time_1ms++;
	}

	if(!(time_1ms % 500)){
		LED_SystemReverse();
	}
}


/**************************************************/
//函数名字:void Tim4_Init(u16 period_num,u16 prescaler_num)
//输入参数:period_num:计数值
//		   prescaler_num:分频系数 >=1
//输出参数:
//描述:用于基本定时器，向上计数
/**************************************************/
void Tim4_Init(u16 period_num,u16 prescaler_num)
{
	TIM_TimeBaseInitTypeDef TIM_TimeBaseInitStruct;

	RCC_APB1PeriphClockCmd(RCC_APB1Periph_TIM4,ENABLE);

	TIM_TimeBaseInitStruct.TIM_ClockDivision = TIM_CKD_DIV1;
	TIM_TimeBaseInitStruct.TIM_CounterMode = TIM_CounterMode_Up;
	TIM_TimeBaseInitStruct.TIM_Period = period_num;
	TIM_TimeBaseInitStruct.TIM_Prescaler = prescaler_num - 1;	
	TIM_TimeBaseInit(TIM4,&TIM_TimeBaseInitStruct);

	TIM_Cmd(TIM4,ENABLE);
}
