jerryxiee/TPMS-SP370-SP40-FXTH87-Programer-Development-Kit/(notices)

Notices in the files:
SP370/TDA5235 Code/12.SendLFAndReceiveRF/INCLUDE/sys.h:
Copyright(C) ¹ãÖÝÊÐÐÇÒíµç×Ó¿Æ¼¼ÓÐÏÞ¹«Ë¾ 2009-2019
All rights reserved
